oofbaroomf/haptic-headband/cad/01_Front.png

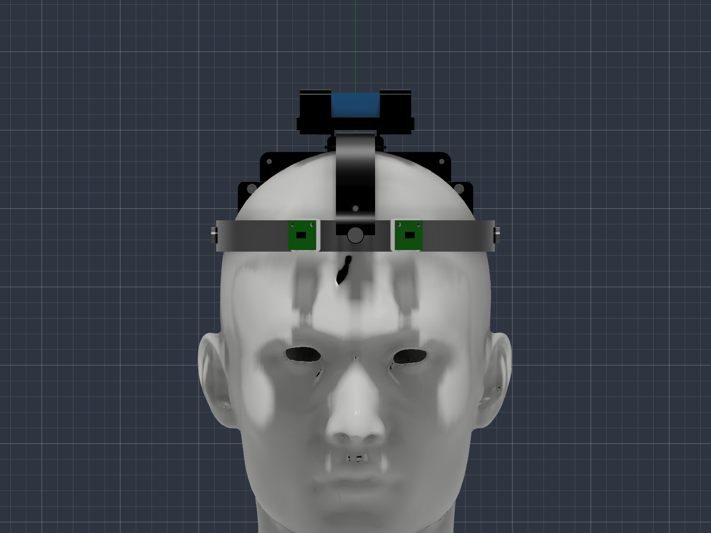
cad/01_Front.png
