oofbaroomf/haptic-headband/cad/02_Rear.png

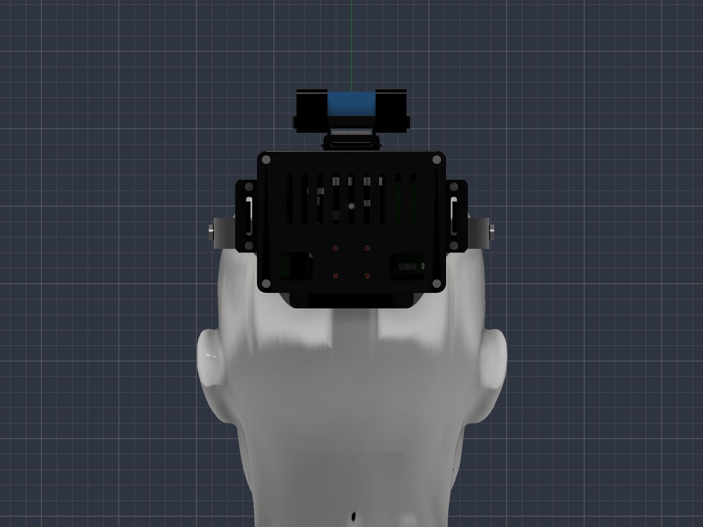
cad/02_Rear.png
