oofbaroomf/haptic-headband/cad/03_Side.png

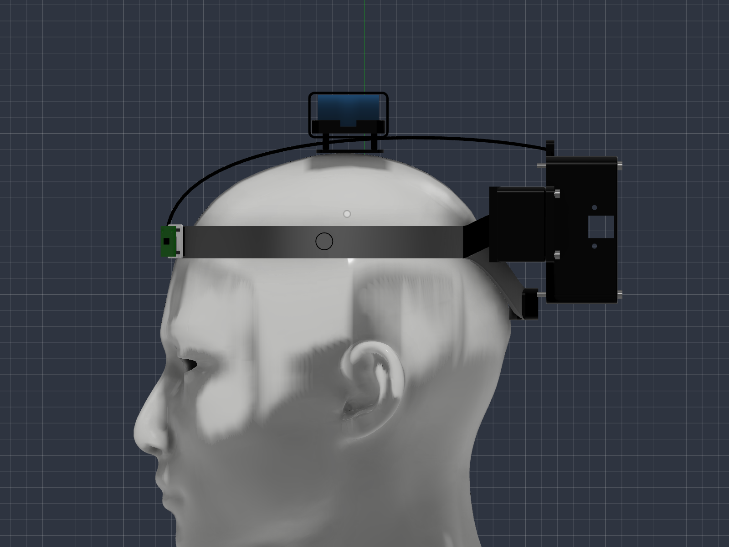
cad/03_Side.png
