oofbaroomf/haptic-headband/cad/04_Top.png

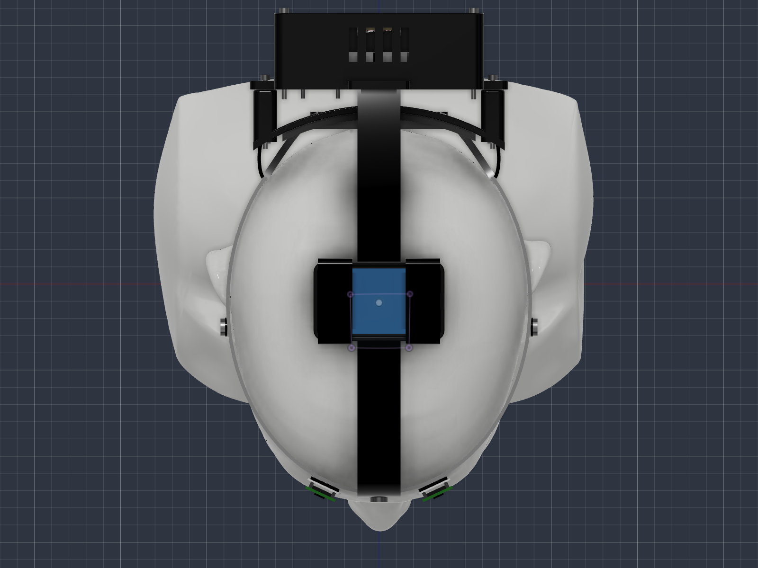
cad/04_Top.png
