oofbaroomf/haptic-headband/cad/06_Headband_Only.png

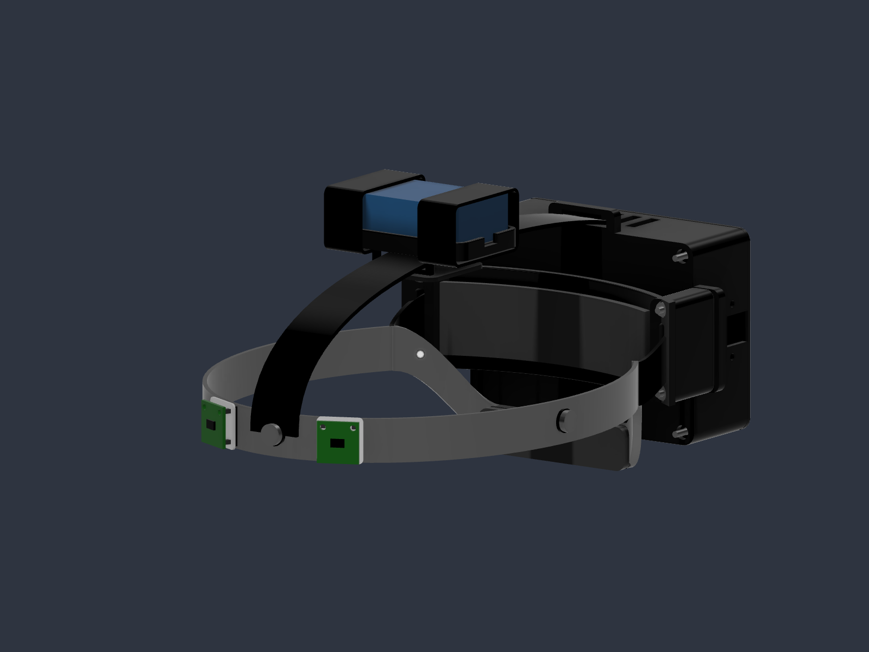
cad/06_Headband_Only.png
