oofbaroomf/haptic-headband/cad/07_Rear_Interior.png

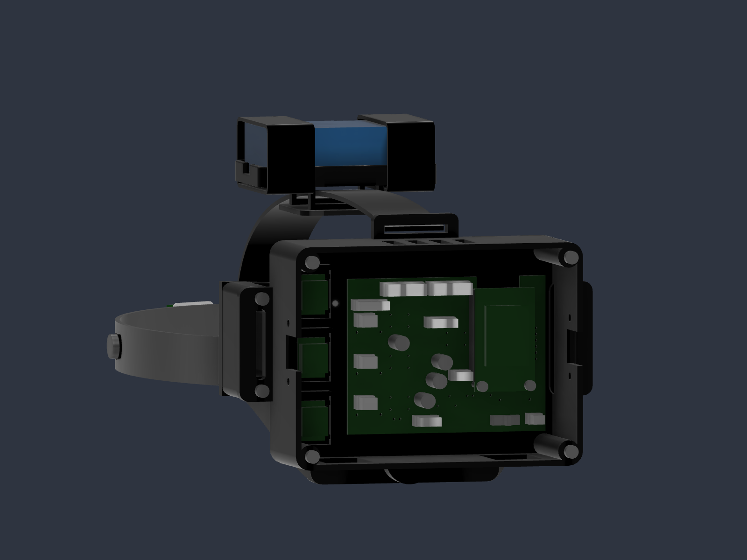
cad/07_Rear_Interior.png
