oofbaroomf/haptic-headband/cad/11_Curved_Saddle.png

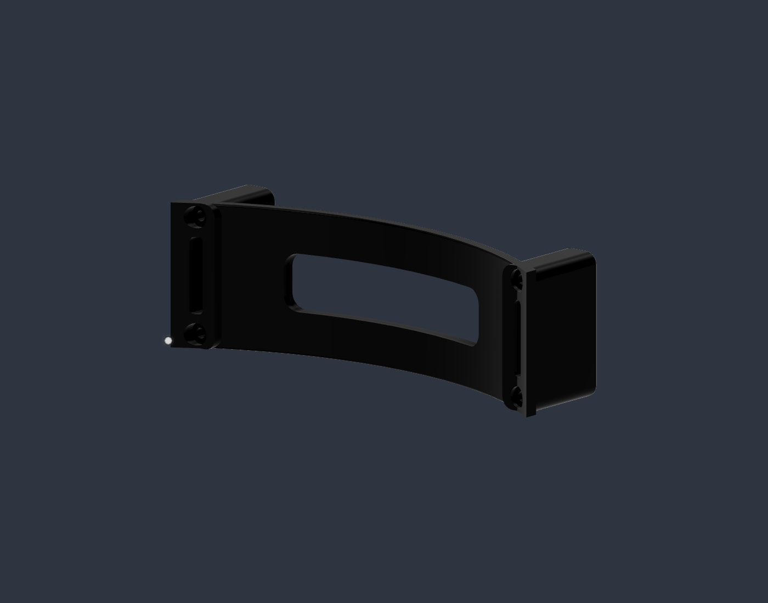
cad/11_Curved_Saddle.png
