oofbaroomf/haptic-headband/BOM.csv

Category | Reference | Quantity | Functional description | Manufacturer | Manufacturer part number | Supplier | Supplier part number | Component value | Package | Footprint | THT/SMD | Electrical rating | Verified datasheet link | Verification status | Assembly notes | Procurement status | Supplier link
Prebuilt module on carrier | U1 | 1 | Exact purchased controller | Adafruit | 4172 | To source |  |  | HUZZAH32 breakout | CAD-derived 36 pads | Socketed THT | VIN34 receives regulated4.70V; BAT30 NC | https://github.com/adafruit/Adafruit-ESP32-HUZZAH-Breakout-PCB | CAD verified; physical fit pending | Two 15-way socket rows plus insulated VIN34 service jumper; leave programming interface accessible; use signal-only programming cable, VIN power contact isolated | Purchased (user reported) | https://github.com/adafruit/Adafruit-ESP32-HUZZAH-Breakout-PCB
Controller PCB | Q1 Q2 Q3 Q5 | 4 | Three motor switches and power-gate control | Diodes Incorporated | DMN2056U-7 | JLCPCB assembly | C332302 |  | SOT23 | Sot23 G1 S2 D3 | SMD | 20V; RDSon <=85mohm at VGS1.5V at25C | https://www.diodes.com/datasheet/download/DMN2056U.pdf | Datasheet/land pattern verified | New selection; not purchased PN2222; qualify thermal layout | Included in R3A PCBA; not yet ordered | https://jlcpcb.com/partdetail/C332302
Controller PCB | Q4 Q6 | 2 | High-side power and reverse battery protection | Diodes Incorporated | DMP2035U-7 | JLCPCB assembly | C110499 |  | SOT23 | Sot23 G1 S2 D3 | SMD | -20V; RDSon <=45mohm at VGS-2.5V at25C | https://www.diodes.com/datasheet/download/DMP2035U.pdf | Datasheet/land pattern verified | Q6 D to raw battery; Q4 S to protected battery | Included in R3A PCBA; not yet ordered | https://jlcpcb.com/partdetail/C110499
Controller PCB | D1 D2 D3 | 3 | Motor flyback rectifiers | STMicroelectronics | 1N5819 | JLCPCB assembly | C110032 |  | DO-41 | Axial P10.16 D2.7 L5.2 | THT | 40V 1A; transient energy still unqualified | https://www.st.com/resource/en/datasheet/1n5819.pdf | Published rating verified; bench clamp test pending | Cathode band goes to motor positive/pad2 | Included in R3A PCBA; not yet ordered | https://jlcpcb.com/partdetail/C110032
Controller PCB | R1 R2 R3 | 3 | Gate resistors | Yageo | MFR-25FTF52-330R | JLCPCB assembly | C1372966 | 330 ohm | 0.25W axial | Axial DIN0207 P7.62 D2.5 L6.3 | THT | 0.25W 1%; body6.3x2.4mm | https://www.yageogroup.com/component-documentation/download/specsheet/MFR-25FBF52-1M | Family/ordering code verified; purchased stock fit pending | Selected new orderable part; compare existing purchased resistors before reuse | Included in R3A PCBA; not yet ordered | https://jlcpcb.com/partdetail/C1372966
Controller PCB | R4 R5 R6 | 3 | Strong reset-state motor OFF bias | Yageo | MFR-25FBF52-1K | JLCPCB assembly | C1364484 | 1k ohm | 0.25W axial | Axial DIN0207 P7.62 D2.5 L6.3 | THT | 0.25W 1%; body6.3x2.4mm | https://www.yageogroup.com/component-documentation/download/specsheet/MFR-25FBF52-1M | Family/ordering code verified; purchased stock fit pending | Selected new orderable part; compare existing purchased resistors before reuse | Included in R3A PCBA; not yet ordered | https://jlcpcb.com/partdetail/C1364484
Controller PCB | R12 | 1 | Power-gate enable pulldown | Yageo | MFR-25FTE52-100K | JLCPCB assembly | C172965 | 100k ohm | 0.25W axial | Axial DIN0207 P7.62 D2.5 L6.3 | THT | 0.25W 1%; body6.3x2.4mm | https://www.yageogroup.com/component-documentation/download/specsheet/MFR-25FBF52-1M | Family/ordering code verified; purchased stock fit pending | Selected new orderable part; compare existing purchased resistors before reuse | Included in R3A PCBA; not yet ordered | https://jlcpcb.com/partdetail/C172965
Controller PCB | R10 R11 R13 R14 | 4 | Power gate pullup and switch series resistor | Yageo | MFR-25FTE52-10K | JLCPCB assembly | C172967 | 10k ohm | 0.25W axial | Axial DIN0207 P7.62 D2.5 L6.3 | THT | 0.25W 1%; body6.3x2.4mm | https://www.yageogroup.com/component-documentation/download/specsheet/MFR-25FBF52-1M | Family/ordering code verified; purchased stock fit pending | Selected new orderable part; compare existing purchased resistors before reuse | Included in R3A PCBA; not yet ordered | https://jlcpcb.com/partdetail/C172967
Controller PCB | C1 | 1 | Bulk/sensor decoupling | Panasonic | EEUFR1A221 | JLCPCB assembly | C407869 | 220uF | Radial electrolytic | Radial D6.3 P2.5 | THT | 10V;455mArms100kHz;.13ohm | https://industrial.panasonic.com/content/data/CP/PDF/S_Alm_A_cap_catalog_am.pdf | Manufacturer dimensions verified; operating ripple test pending | Positive lead pad1; C1/C2 height11.2mm; C3 height11.0mm | Included in R3A PCBA; not yet ordered | https://jlcpcb.com/partdetail/C407869
Controller PCB | C2 | 1 | Bulk/sensor decoupling | Panasonic | EEUFM1E101 | JLCPCB assembly | C713389 | 100uF | Radial electrolytic | Radial D6.3 P2.5 | THT | 25V;455mArms100kHz;0.13ohm;2000h105C | https://industrial.panasonic.com/content/data/CP/PDF/S_Alm_A_cap_catalog_am.pdf | Manufacturer dimensions verified; operating ripple test pending | Positive lead pad1; C1/C2 height11.2mm; C3 height11.0mm | Included in R3A PCBA; not yet ordered | https://jlcpcb.com/partdetail/C713389
Controller PCB | C3 | 1 | Bulk/sensor decoupling | Panasonic | EEUFM1E101 | JLCPCB assembly | C713389 | 100uF | Radial electrolytic | Radial D6.3 P2.5 | THT | 25V;455mArms100kHz;0.13ohm;2000h105C | https://industrial.panasonic.com/content/data/CP/PDF/S_Alm_A_cap_catalog_am.pdf | Manufacturer dimensions verified; operating ripple test pending | Positive pad1. Replaces 47uF; sensor reservoir only. New R3A footprint. | Included in R3A PCBA; not yet ordered | https://jlcpcb.com/partdetail/C713389
Controller PCB | C10 | 1 | Controller-input radio-burst reservoir | Panasonic | EEUFR1A221 | JLCPCB assembly | C407869 | 220uF | Radial electrolytic | Radial D6.3 P2.5 | THT | 10V; 455mArms at100kHz; ESR0.13ohm | https://industrial.panasonic.com/content/data/CP/PDF/S_Alm_A_cap_catalog_am.pdf | Manufacturer footprint checked; transient qualification required | Positive pad1 to VCTRL_4V7; leave room for 11.2mm height | Included in R3A PCBA; not yet ordered | https://jlcpcb.com/partdetail/C407869
Controller PCB | SW1 | 1 | Purchased physical slide switch | Adafruit / Dongguan Haoyu | 805 / SS-12E17G2 | To source |  |  | SPDT THT | Switch805 P2.50 drill1.0 | THT | 0.5A DC50V; carries enable current only | https://cdn-shop.adafruit.com/product-files/805/SS-12E17G2-revised.pdf | Drawing inspected; purchased fit pending | Common2; unused1 NC; ON3; continuity-test actuator direction | Purchased (user reported) | https://cdn-shop.adafruit.com/product-files/805/SS-12E17G2-revised.pdf
Controller PCB | J1 J2 J3 | 3 | Motor interfaces | JST | B2B-XH-A(LF)(SN) | JLCPCB assembly | C158012 | 2 positions | XH keyed vertical header | XH 2x1 P2.5 | THT | 3A with specified contacts | https://www.jst.com/wp-content/uploads/2025/06/eXH.pdf | Manufacturer geometry checked; actual mating harness pending | Component-side pin1 at left; PH regulator unused positions NC; no unkeyed substitutes | Included in R3A PCBA; not yet ordered | https://jlcpcb.com/partdetail/C158012
Controller PCB | J4 J5 | 2 | ToF interfaces | JST | B6B-XH-A(LF)(SN) | JLCPCB assembly | C144397 | 6 positions | XH keyed vertical header | XH 6x1 P2.5 | THT | 3A with specified contacts | https://www.jst.com/wp-content/uploads/2025/06/eXH.pdf | Manufacturer geometry checked; actual mating harness pending | Component-side pin1 at left; PH regulator unused positions NC; no unkeyed substitutes | Included in R3A PCBA; not yet ordered | https://jlcpcb.com/partdetail/C144397
Controller PCB | J6 | 1 | IMU interface | JST | B6B-PH-K-S(LF)(SN) | JLCPCB assembly | C131342 | 6 positions | PH keyed vertical header | PH 6x1 P2 | THT | 2A with specified AWG24 contacts | https://www.jst.com/wp-content/uploads/2021/08/ePH-new.pdf | Manufacturer geometry checked; actual mating harness pending | Component-side pin1 at left; PH regulator unused positions NC; no unkeyed substitutes | Included in R3A PCBA; not yet ordered | https://jlcpcb.com/partdetail/C131342
Controller PCB | J7 | 1 | Fused battery input | JST | B2B-PH-K-S(LF)(SN) | JLCPCB assembly | C131337 | 2 positions | PH keyed vertical header | PH 2x1 P2 | THT | 2A with specified AWG24 contacts | https://www.jst.com/wp-content/uploads/2021/08/ePH-new.pdf | Manufacturer geometry checked; actual mating harness pending | Component-side pin1 at left; PH regulator unused positions NC; no unkeyed substitutes | Included in R3A PCBA; not yet ordered | https://jlcpcb.com/partdetail/C131337
Controller PCB | J8 | 1 | Sensor regulator | JST | B3B-PH-K-S(LF)(SN) | JLCPCB assembly | C131339 | 3 positions | PH keyed vertical header | PH 3x1 P2 | THT | 2A with specified AWG24 contacts | https://www.jst.com/wp-content/uploads/2021/08/ePH-new.pdf | Manufacturer geometry checked; actual mating harness pending | Component-side pin1 at left; PH regulator unused positions NC; no unkeyed substitutes | Included in R3A PCBA; not yet ordered | https://jlcpcb.com/partdetail/C131339
Controller PCB | J9 | 1 | Motor regulator | JST | B4B-PH-K-S(LF)(SN) | JLCPCB assembly | C131334 | 4 positions | PH keyed vertical header | PH 4x1 P2 | THT | 2A with specified AWG24 contacts | https://www.jst.com/wp-content/uploads/2021/08/ePH-new.pdf | Manufacturer geometry checked; actual mating harness pending | Component-side pin1 at left; PH regulator unused positions NC; no unkeyed substitutes | Included in R3A PCBA; not yet ordered | https://jlcpcb.com/partdetail/C131334
Controller PCB | J10 | 1 | Controller regulator | JST | B5B-PH-K-S(LF)(SN) | JLCPCB assembly | C157993 | 5 positions | PH keyed vertical header | PH 5x1 P2 | THT | 2A with specified AWG24 contacts | https://www.jst.com/wp-content/uploads/2021/08/ePH-new.pdf | Manufacturer geometry checked; actual mating harness pending | Component-side pin1 at left; PH regulator unused positions NC; no unkeyed substitutes | Included in R3A PCBA; not yet ordered | https://jlcpcb.com/partdetail/C157993
Controller PCB | JP1 | 1 | Arming/test header | Samtec | TSW-102-07-G-S | JLCPCB assembly | C7402729 | 2 positions | 2.54mm header | Header 2x1 | THT | System 2A target | https://www.samtec.com/products/tsw-102-07-g-s | Manufacturer geometry verified | JP1 normally open; TP1 not a harness socket | Included in R3A PCBA; not yet ordered | https://jlcpcb.com/partdetail/C7402729
Controller PCB | TP1 | 0 | Arming/test header | Samtec | TSW-106-07-G-S | To source |  | 6 positions | 2.54mm header | Header 6x1 | THT | System 2A target | https://www.samtec.com/products/tsw-106-07-g-s | Manufacturer geometry verified | Leave header unfitted; probe labelled holes. No purchase required. | DNP; use probe holes | https://www.samtec.com/products/tsw-106-07-g-s
Controller PCB | U2 | 1 | Dual-supply I2C powered-off isolation | Texas Instruments | TCA9517DR | JLCPCB assembly | C182421 |  | SOIC8 | TI D SOIC8 1.27mm | SMD | Aside sensor; Bside ESP; 400kHz maximum | https://www.ti.com/lit/ds/symlink/tca9517.pdf | Manufacturer pinout and land pattern checked | Not galvanic isolation; common ground required | Included in R3A PCBA; not yet ordered | https://jlcpcb.com/partdetail/C182421
Controller PCB | U6 | 1 | Battery ADC powered-off isolation | Texas Instruments | SN74CBTLV1G125DBVR | JLCPCB assembly | C2653264 |  | SOT23-5 | TI DBV | SMD | 2.3-3.6V supply; Ioff10uA maximum | https://www.ti.com/lit/ds/symlink/sn74cbtlv1g125.pdf | Datasheet checked | GPIO33 open-drain enable; divider ratio approximately3:1; calibrate | Included in R3A PCBA; not yet ordered | https://jlcpcb.com/partdetail/C2653264
Controller PCB | U3 | 1 | Open-drain LP isolation | Texas Instruments | SN74LVC2G07DBVR | JLCPCB assembly | C37708 |  | SOT23-6 | TI DBV 0.95mm | SMD | Ioff partial-power-down; output sink only | https://www.ti.com/lit/ds/symlink/sn74lvc2g07.pdf | Manufacturer pinout and land pattern checked | Controller-side pullups; never pull LP output to 3.3V | Included in R3A PCBA; not yet ordered | https://jlcpcb.com/partdetail/C37708
Controller PCB | U4 U5 | 2 | UART powered-off isolation | Texas Instruments | SN74LVC1G125DBVR | JLCPCB assembly | C23654 |  | SOT23-5 | TI DBV 0.95mm | SMD | Ioff partial-power-down; 5.5V tolerant input | https://www.ti.com/lit/ds/symlink/sn74lvc1g125.pdf | Manufacturer pinout and land pattern checked | Each buffer powered by receiving domain; OE grounded | Included in R3A PCBA; not yet ordered | https://jlcpcb.com/partdetail/C23654
Controller PCB | R15 R16 | 2 | Interface bias | Yageo | RC1206FR-074K7L | JLCPCB assembly | C137262 | 4.7k | 1206 | Chip1206 | SMD | 1%; 0.25W | https://yageogroup.com/component-documentation/download/specsheet/RC1206FR-0710KL | Manufacturer package dimensions checked | Not confirmed purchased | Included in R3A PCBA; not yet ordered | https://jlcpcb.com/partdetail/C137262
Controller PCB | R17 R18 R21 R22 | 4 | Interface bias | Yageo | RC1206FR-0710KL | JLCPCB assembly | C132649 | 10k | 1206 | Chip1206 | SMD | 1%; 0.25W | https://yageogroup.com/component-documentation/download/specsheet/RC1206FR-0710KL | Manufacturer package dimensions checked | Not confirmed purchased | Included in R3A PCBA; not yet ordered | https://jlcpcb.com/partdetail/C132649
Controller PCB | R19 R20 | 2 | Interface bias | Yageo | RC1206FR-07100KL | JLCPCB assembly | C137393 | 100k | 1206 | Chip1206 | SMD | 1%; 0.25W | https://yageogroup.com/component-documentation/download/specsheet/RC1206FR-0710KL | Manufacturer package dimensions checked | Not confirmed purchased | Included in R3A PCBA; not yet ordered | https://jlcpcb.com/partdetail/C137393
Controller PCB | C4 C5 C6 C7 C8 C9 | 6 | Local interface decoupling | KEMET | C1206C104K5RACTU | JLCPCB assembly | C41430990 | 100nF | 1206 | Chip1206 | SMD | 50V X7R 10% | https://search.kemet.com/component-documentation/download/specsheet/C1206C104K5RACTU | Manufacturer package dimensions checked | Not confirmed purchased | Included in R3A PCBA; not yet ordered | https://jlcpcb.com/partdetail/C41430990
Controller PCB | F1 | 1 | PCB-mounted battery-positive fuse | Littelfuse | 0251002.NRT1L | JLCPCB assembly | C151088 | 2A | Axial PICO 251 | Axial P12.7 D2.8 L7.11 drill1.0 | THT | 125V; 300A DC interrupt; very fast acting | https://www.littelfuse.com/assetdocs/littelfuse-fuse-251-253-datasheet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 | Datasheet reviewed; coordination pending | J7.1 to F1.1; F1.2 feeds BAT_RAW; same 251-series2A. No inline fuse adapter required. Use protected pack with short retained leads. | Included in R3A PCBA; not yet ordered | https://jlcpcb.com/partdetail/C151088
Harness mating part | MATE_PH2 | 0 | Keyed cable housing | JST | PHR-2 | To source |  | 2 circuits | PH | External | Wired | Use AWG24; 2A | https://www.jst.com/wp-content/uploads/2021/08/ePH-new.pdf | Manufacturer family verified | Housing alone excludes contacts; use matching crimp tool | Removed in R3A; use protected battery integral connector after polarity check | https://www.jst.com/wp-content/uploads/2021/08/ePH-new.pdf
Harness mating part | MATE_PH3 | 1 | Keyed cable housing | JST | PHR-3 | To source |  | 3 circuits | PH | External | Wired | Use AWG24; 2A | https://www.jst.com/wp-content/uploads/2021/08/ePH-new.pdf | Manufacturer family verified | Housing alone excludes contacts; use matching crimp tool | Planned / not confirmed purchased | https://www.jst.com/wp-content/uploads/2021/08/ePH-new.pdf
Harness mating part | MATE_PH4 | 1 | Keyed cable housing | JST | PHR-4 | To source |  | 4 circuits | PH | External | Wired | Use AWG24; 2A | https://www.jst.com/wp-content/uploads/2021/08/ePH-new.pdf | Manufacturer family verified | Housing alone excludes contacts; use matching crimp tool | Planned / not confirmed purchased | https://www.jst.com/wp-content/uploads/2021/08/ePH-new.pdf
Harness mating part | MATE_PH5 | 1 | Keyed cable housing | JST | PHR-5 | To source |  | 5 circuits | PH | External | Wired | Use AWG24; 2A | https://www.jst.com/wp-content/uploads/2021/08/ePH-new.pdf | Manufacturer family verified | Housing alone excludes contacts; use matching crimp tool | Planned / not confirmed purchased | https://www.jst.com/wp-content/uploads/2021/08/ePH-new.pdf
Harness mating part | MATE_PH6 | 1 | Keyed cable housing | JST | PHR-6 | To source |  | 6 circuits | PH | External | Wired | Use AWG24; 2A | https://www.jst.com/wp-content/uploads/2021/08/ePH-new.pdf | Manufacturer family verified | Housing alone excludes contacts; use matching crimp tool | Planned / not confirmed purchased | https://www.jst.com/wp-content/uploads/2021/08/ePH-new.pdf
Harness mating part | MATE_XH2 | 3 | Keyed cable housing | JST | XHP-2 | To source |  | 2 circuits | XH | External | Wired | Use AWG24; 3A | https://www.jst.com/wp-content/uploads/2025/06/eXH.pdf | Manufacturer family verified | Housing alone excludes contacts; use matching crimp tool | Planned / not confirmed purchased | https://www.jst.com/wp-content/uploads/2025/06/eXH.pdf
Harness mating part | MATE_XH6 | 2 | Keyed cable housing | JST | XHP-6 | To source |  | 6 circuits | XH | External | Wired | Use AWG24; 3A | https://www.jst.com/wp-content/uploads/2025/06/eXH.pdf | Manufacturer family verified | Housing alone excludes contacts; use matching crimp tool | Planned / not confirmed purchased | https://www.jst.com/wp-content/uploads/2025/06/eXH.pdf
Harness mating part | CONTACT_PH | 10 | Double-ended pre-crimped leads; cut in half | JST | ASPHSPH24K305 | DigiKey | 455-3083-ND | 24 AWG | 304.8 mm double-ended lead | External cable | Wired | PH contacts, 24 AWG | https://www.digikey.co.uk/en/products/detail/jst-sales-america-inc/ASPHSPH24K305/6009459 | Exact pre-crimp family verified | 20 half-leads per pack of10; no crimp tool or separate terminals | Planned / not confirmed purchased | https://www.digikey.co.uk/en/products/detail/jst-sales-america-inc/ASPHSPH24K305/6009459
Harness mating part | CONTACT_XH | 10 | Double-ended pre-crimped leads; cut in half | JST | ASXHSXH22K305 | DigiKey | 455-3241-ND | 22 AWG | 304.8 mm double-ended lead | External cable | Wired | XH contacts, 22 AWG | https://www.digikey.co.uk/en/products/detail/jst-sales-america-inc/ASXHSXH22K305/6684932 | Exact pre-crimp family verified | 20 half-leads per pack of10; no crimp tool or separate terminals | Planned / not confirmed purchased | https://www.digikey.co.uk/en/products/detail/jst-sales-america-inc/ASXHSXH22K305/6684932
Mechanical assembly | SK1 SK2 | 2 | HUZZAH socket strips | Samtec | SSW-115-01-T-S | JLCPCB assembly | C6686518 | 15 positions | 2.54mm single row female | Header row length35.56 | THT | Mechanical stack/clearance to verify | https://www.samtec.com/products/ssw-115-01-t-s | Family confirmed; selected tin variant dry fit pending | Sockets occupy U1 main rows; no separate PCB reference required | Included in R3A PCBA; not yet ordered | https://jlcpcb.com/partdetail/C6686518
Remote wired module | TOF_LEFT TOF_RIGHT | 2 | Purchased ToF breakout | Pimoroni | PIM622 | To source |  |  | 19x19mm breakout | Not mounted on carrier | Remote | Published input3-6V; host bus3.3V | https://cdn.shopify.com/s/files/1/0174/1800/files/VL53L5CX-schematic.pdf?v=1654004213 | Schematic verified; module revision/harness test pending | Rear LP wire required; open-drain controls | Purchased (user reported) | https://cdn.shopify.com/s/files/1/0174/1800/files/VL53L5CX-schematic.pdf?v=1654004213
Remote wired module | IMU1 | 1 | Purchased inertial breakout | Adafruit | 4754 (selected; confirm purchased SKU) | To source |  |  | BNO085 module | Not mounted on carrier | Remote | VIN3-5V;3.3V UART | https://learn.adafruit.com/adafruit-9-dof-orientation-imu-fusion-breakout-bno085/pinouts | Pinout verified; exact purchased SKU/revision pending | P1high/P0low normal UART; never power3VO | Purchased (user reported) | https://learn.adafruit.com/adafruit-9-dof-orientation-imu-fusion-breakout-bno085/pinouts
New external power module | REG_SENS | 1 | Independent sensor buck-boost | Pololu | S7V8F3 / 2122 | To source |  | 3.3V | Module11.4x16.5mm | Wired to J8 | Remote module | VIN2.7-11.8V; current depends on conditions | https://www.pololu.com/product/2122 | Published capability verified; .30A allocation needs test | New purchase required; label-based wiring; SHDN open; insulate/mount | Planned / not confirmed purchased | https://www.pololu.com/product/2122
New external power module | REG_MOTOR | 1 | Adjustable motor buck-boost | Pololu | S7V8A / 2118 | To source |  | 3.0V | Module11.4x16.5mm | Wired to J9 | Remote module | VIN2.7-11.8V; VOUT2.5-8V | https://www.pololu.com/product/2118 | Reference motor voltage/current verified; batch and transient test pending | Set3.00V; accept2.90-3.10V under load; secure trimmer; no motors above3.8V | Planned / not confirmed purchased | https://www.pololu.com/product/2118
Remote purchased component | M_LEFT M_RIGHT M_FRONT | 3 | Pi Hut vibration discs SKU102867 | Batch manufacturer unconfirmed | Reference only: 10B27.3018 / Adafruit1201 | The Pi Hut | 102867 | 3.0V target | 10x2.7mm coin reference | Not mounted on carrier | Wired | Reference:2.5-3.8V;75mA running;120mA starting at25C | https://cdn-shop.adafruit.com/product-files/1201/P1012_datasheet.pdf | Reference verified; batch equivalence unconfirmed | Three purchased motors; measure startup; JP1 normally open | Purchased (user reported) | https://thepihut.com/products/vibrating-mini-motor-disc
Remote planned component | BAT1 | 1 | Pimoroni BAT0007 protected parallel-cell pack | PKCell | ICR18650 4400mAh 3.7V | Pimoroni | BAT0007 | 4400mAh typical;3960mAh minimum | 1S2P lithium-ion | External to PCB | Wired | 4.2V charge;3.0V cutoff;3A max continuous charge/discharge | https://cdn.shopify.com/s/files/1/0174/1800/files/PKcell_ICR18650_4400mAh_Final.pdf?11497089046215477949= | Manufacturer reference verified; not purchased | Protected pack directly to J7 only after verifying + on J7.1 and - on J7.2. F1 now onboard. Short intact retained cable; unplug to charge. | Planned / not confirmed purchased | https://shop.pimoroni.com/products/lithium-ion-battery-pack?variant=23417820423
New external power module | REG_CTRL | 1 | Adjustable controller supply for wireless demo | Pololu | S7V8A / 2118 | To source |  | 4.70V | Module11.4x16.5mm | Wired to J10 | Remote module | VIN2.7-11.8V;typical500mA-1A output; thermal qualification required | https://www.pololu.com/product/2118 | Set4.70V; qualify4.415-4.985V at HUZZ input under load | Distinct 4V7 label; secure trimmer; VOUT to J10.3 then U1 VIN34; BAT30 NC; programmer power absent | Planned / not confirmed purchased | https://www.pololu.com/product/2118
External charging accessory | CHARGER1 | 1 | Purchased USB-C charger | Adafruit | 4410 | To source |  |  | MicroLipo USB-C | Not on carrier | External | 100mA default;500mA selectable | https://www.adafruit.com/product/4410 | 4.2V chemistry/current compatible; physical polarity mandatory | Pack disconnected from carrier;100mA default or500mA bridge; no load sharing | Purchased (user reported) | https://www.adafruit.com/product/4410
Not fitted | JP1_SHUNT | 1 | Motor arming shunt | Harwin | M7566-05 | To source |  | 2.54mm shunt | 2-pin jumper | JP1 | Manual | 3A at25C;2.54mm pitch;0.64mm square mating post | https://www.harwin.com/products/M7566-05 | Published rating verified; DNP until motor qualification | Red open shunt;5.00x2.30x6.30mm; fit only after electrical acceptance | DNP - not installed | https://www.harwin.com/products/M7566-05
Custom external harness | HARNESS_BAT | 0 | Retained polarity-verified battery adapter | Custom assembly | HB-BAT-ADAPTER-01 (assembly drawing, not vendor MPN) | To source |  | AWG24 PH leads; fused near battery connector | JST-PH2.0 keyed fused adapter | External to PCB | Wired | >=2A continuous mating-contact requirement |  | Actual matching connector required; meter polarity and qualify retention | Removed: F1 is on R3A PCB. Retain protected pack factory lead; meter polarity before J7. | Removed in R3A
Custom external harness | HARNESS_CTRL | 1 | Insulated removable VIN service jumper | Custom assembly | HB-VIN-JUMPER-01 (assembly drawing, not vendor MPN) | To source |  | 4.70V controller link | Insulated wire/link | Carrier U1.34 to breakout VIN | Wired | >=0.5A; insulated >=10V |  | Dry fit and continuity required | Main15-way sockets do not contact VIN34; isolate programmer power lead | Planned / not confirmed purchased
