oofbaroomf/haptic-headband/cad/Headband_Assembly.step

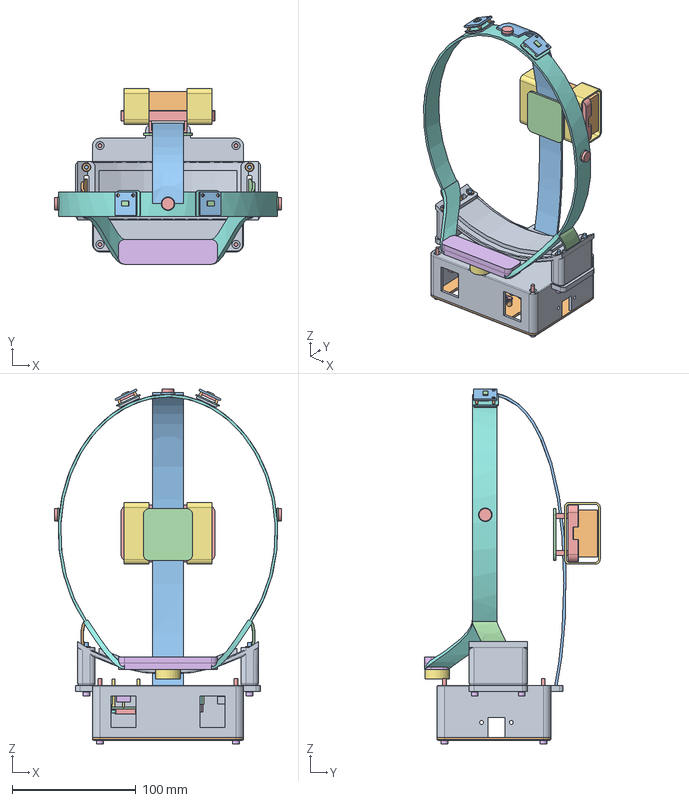
[picture p12: CAD file, 2026-11-01]
cad/Headband_Assembly.step
184.0 x 142.0 x 287.1 mm
