oofbaroomf/haptic-headband/cad/PRINT_3_Curved_Saddle.step

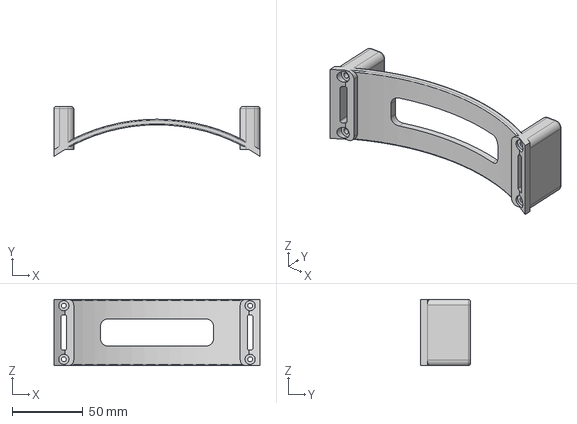
[picture p13: CAD file, 2026-11-01]
cad/PRINT_3_Curved_Saddle.step
146.0 x 35.4 x 47.0 mm
