oofbaroomf/haptic-headband/cad/PRINT_2_Rear_Lid.step

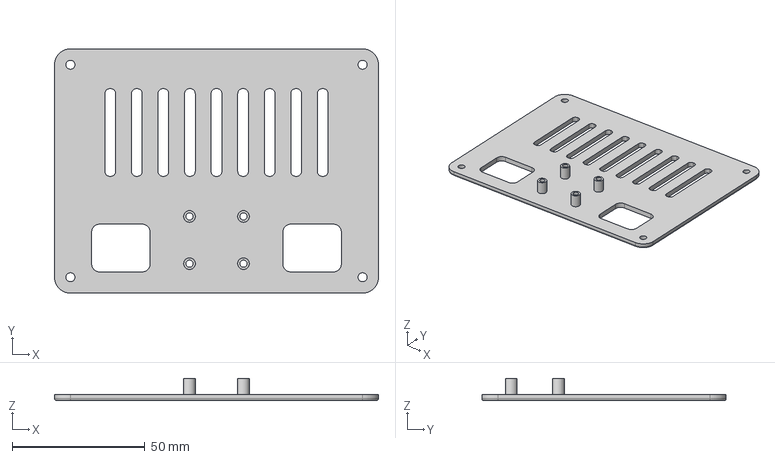
[picture p14: CAD file, 2026-11-01]
cad/PRINT_2_Rear_Lid.step
122.0 x 92.0 x 8.40 mm
