oofbaroomf/haptic-headband/cad/Headband_With_Original_Head.step

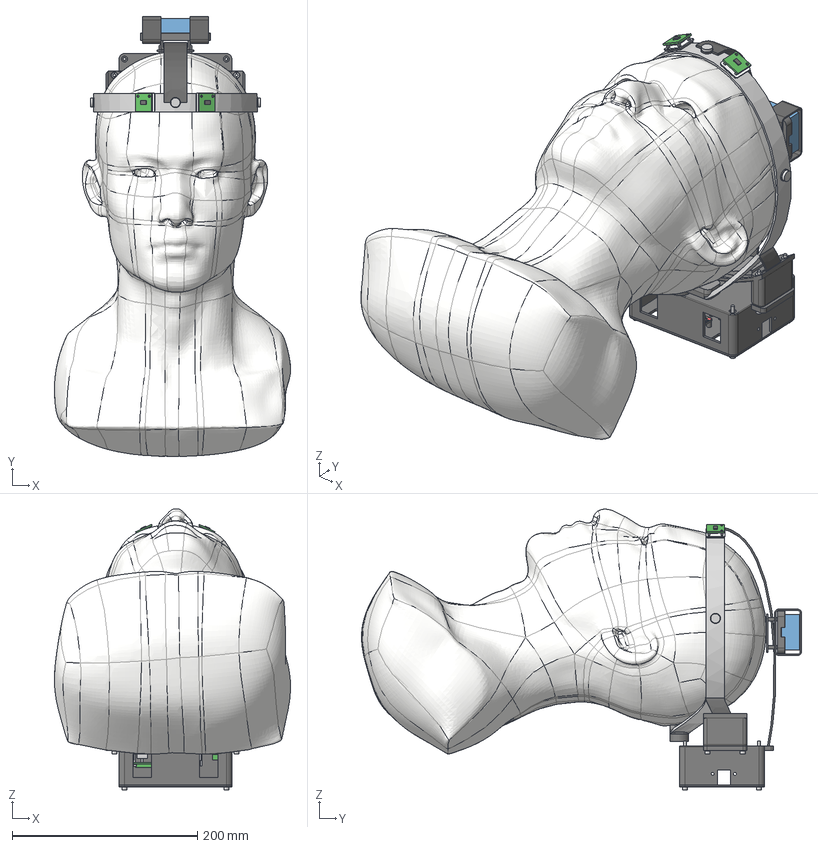
[picture p15: CAD file, 2026-11-01]
cad/Headband_With_Original_Head.step
255.3 x 475.6 x 303.6 mm
