oofbaroomf/haptic-headband/cad/PRINT_1_Rear_Base.step

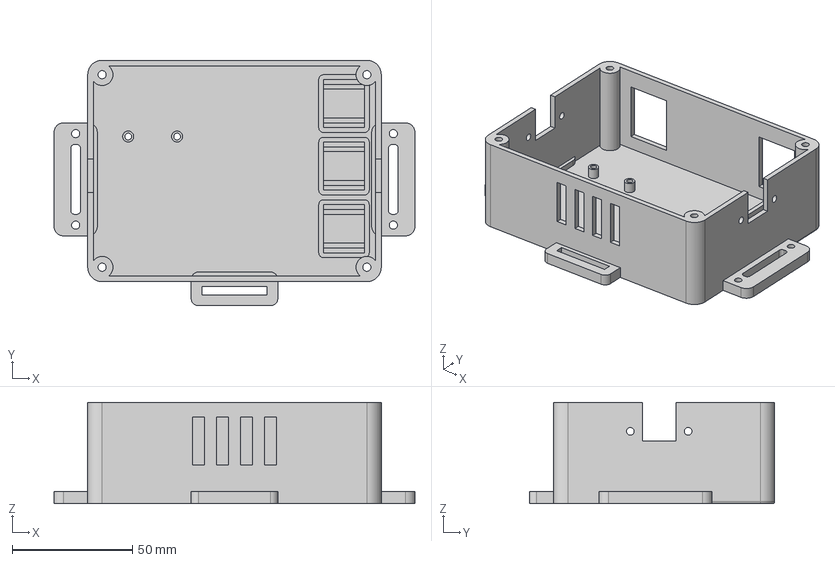
[picture p16: CAD file, 2026-11-01]
cad/PRINT_1_Rear_Base.step
150.0 x 102.0 x 42.0 mm
