oofbaroomf/haptic-headband/cad/PRINT_4_Battery_Tray.step

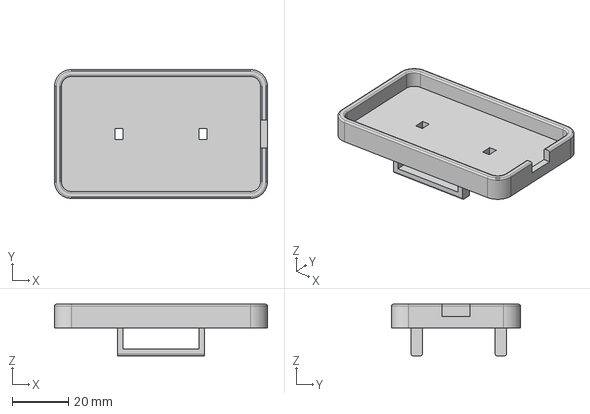
[picture p17: CAD file, 2026-11-01]
cad/PRINT_4_Battery_Tray.step
76.0 x 46.0 x 18.4 mm
