oofbaroomf/haptic-headband/(list of files, cad)

Other CAD files:
cad/Headband_Ergonomic_Revision.f3d
cad/PRINT_1_Rear_Base.stl
cad/PRINT_2_Rear_Lid.stl
cad/PRINT_3_Curved_Saddle.stl
cad/PRINT_4_Battery_Tray.stl
