oofbaroomf/haptic-headband/cad/10_Battery_Strap_Guides.png

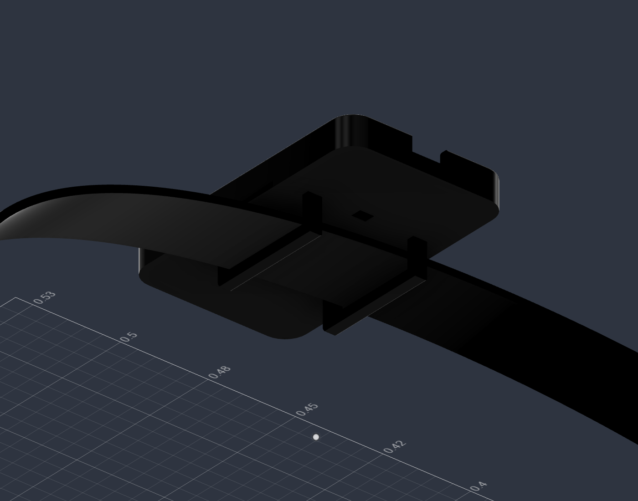
cad/10_Battery_Strap_Guides.png
