oofbaroomf/haptic-headband/pcb/headband-review.kicad_pcb

## KiCad design pcb/headband-review.kicad_pcb (2026-11-01)

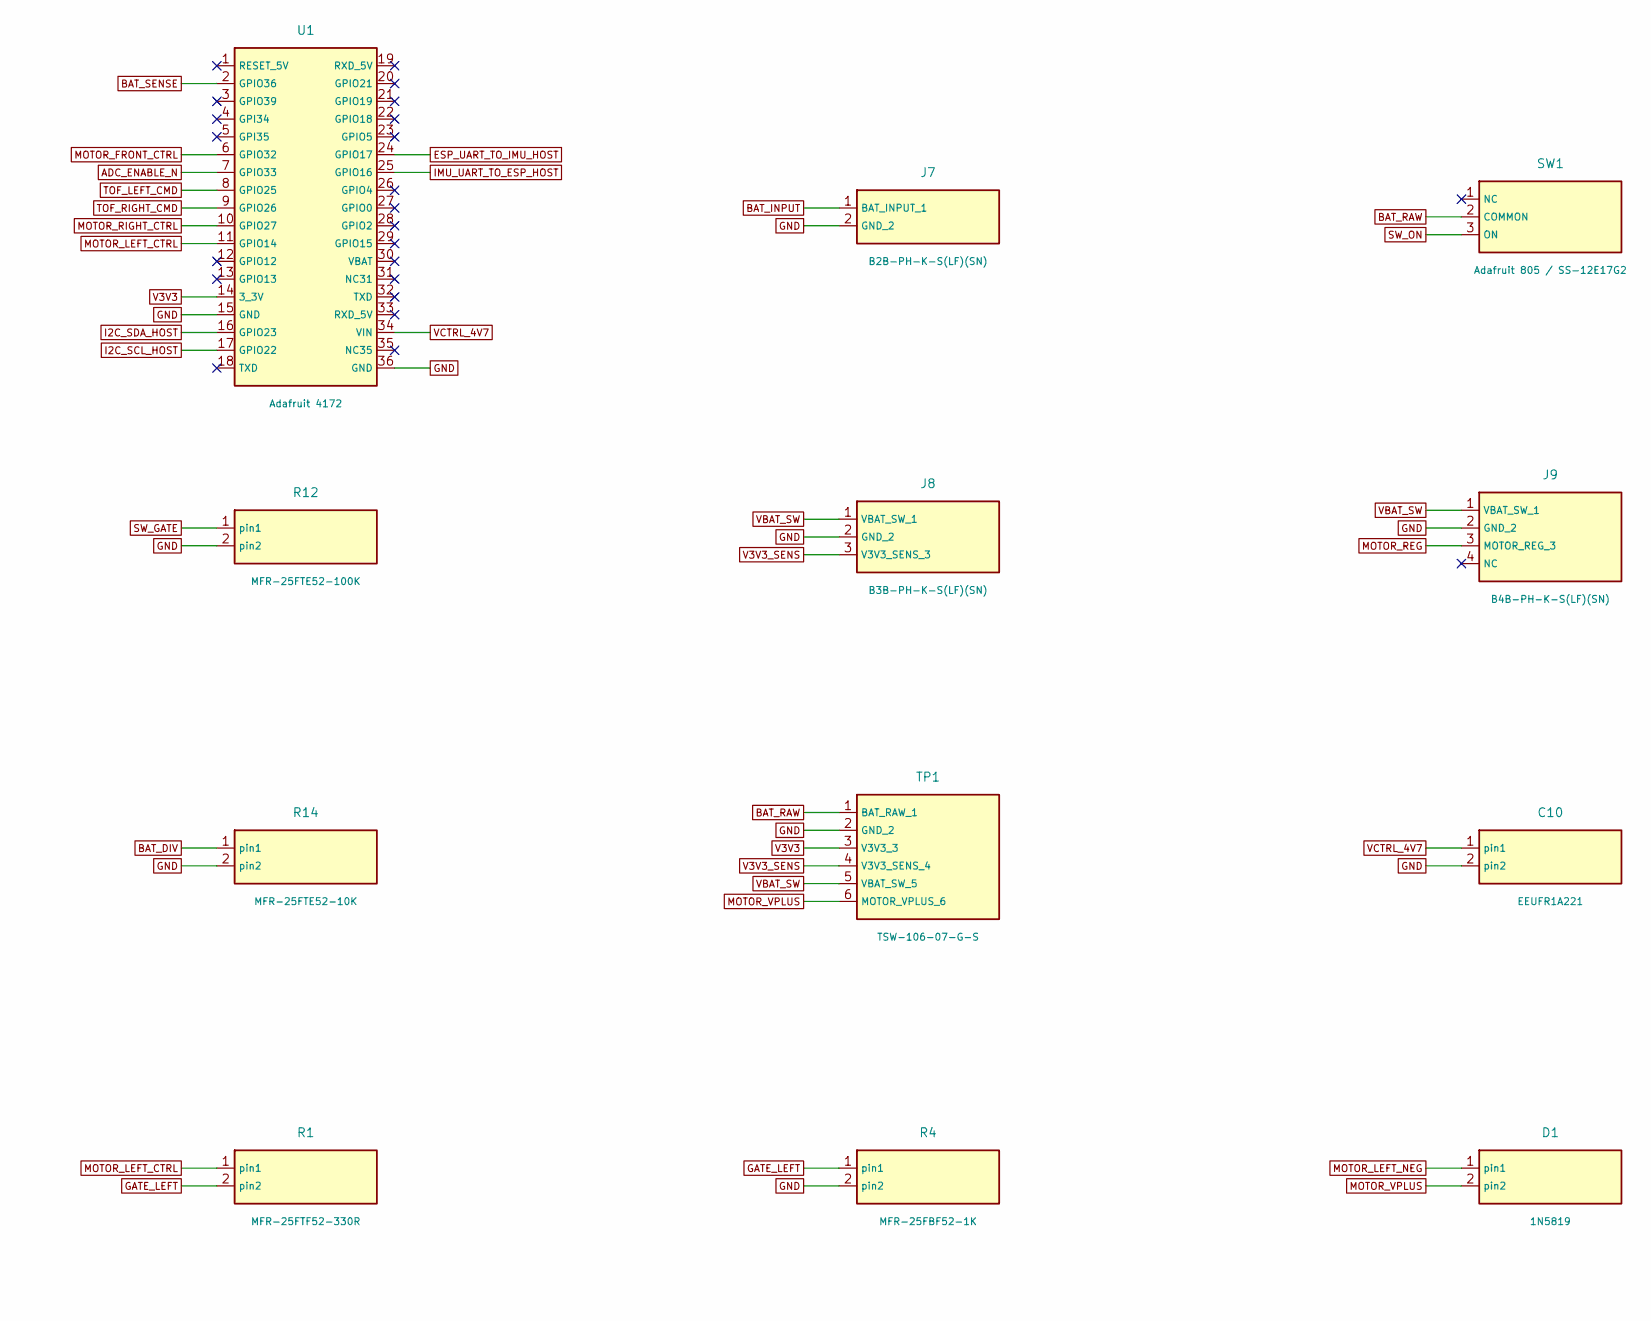
[picture p19: schematic headband-review.kicad_sch, Haptic navigation headband - carrier interface schematic, part in row 1, column 1]

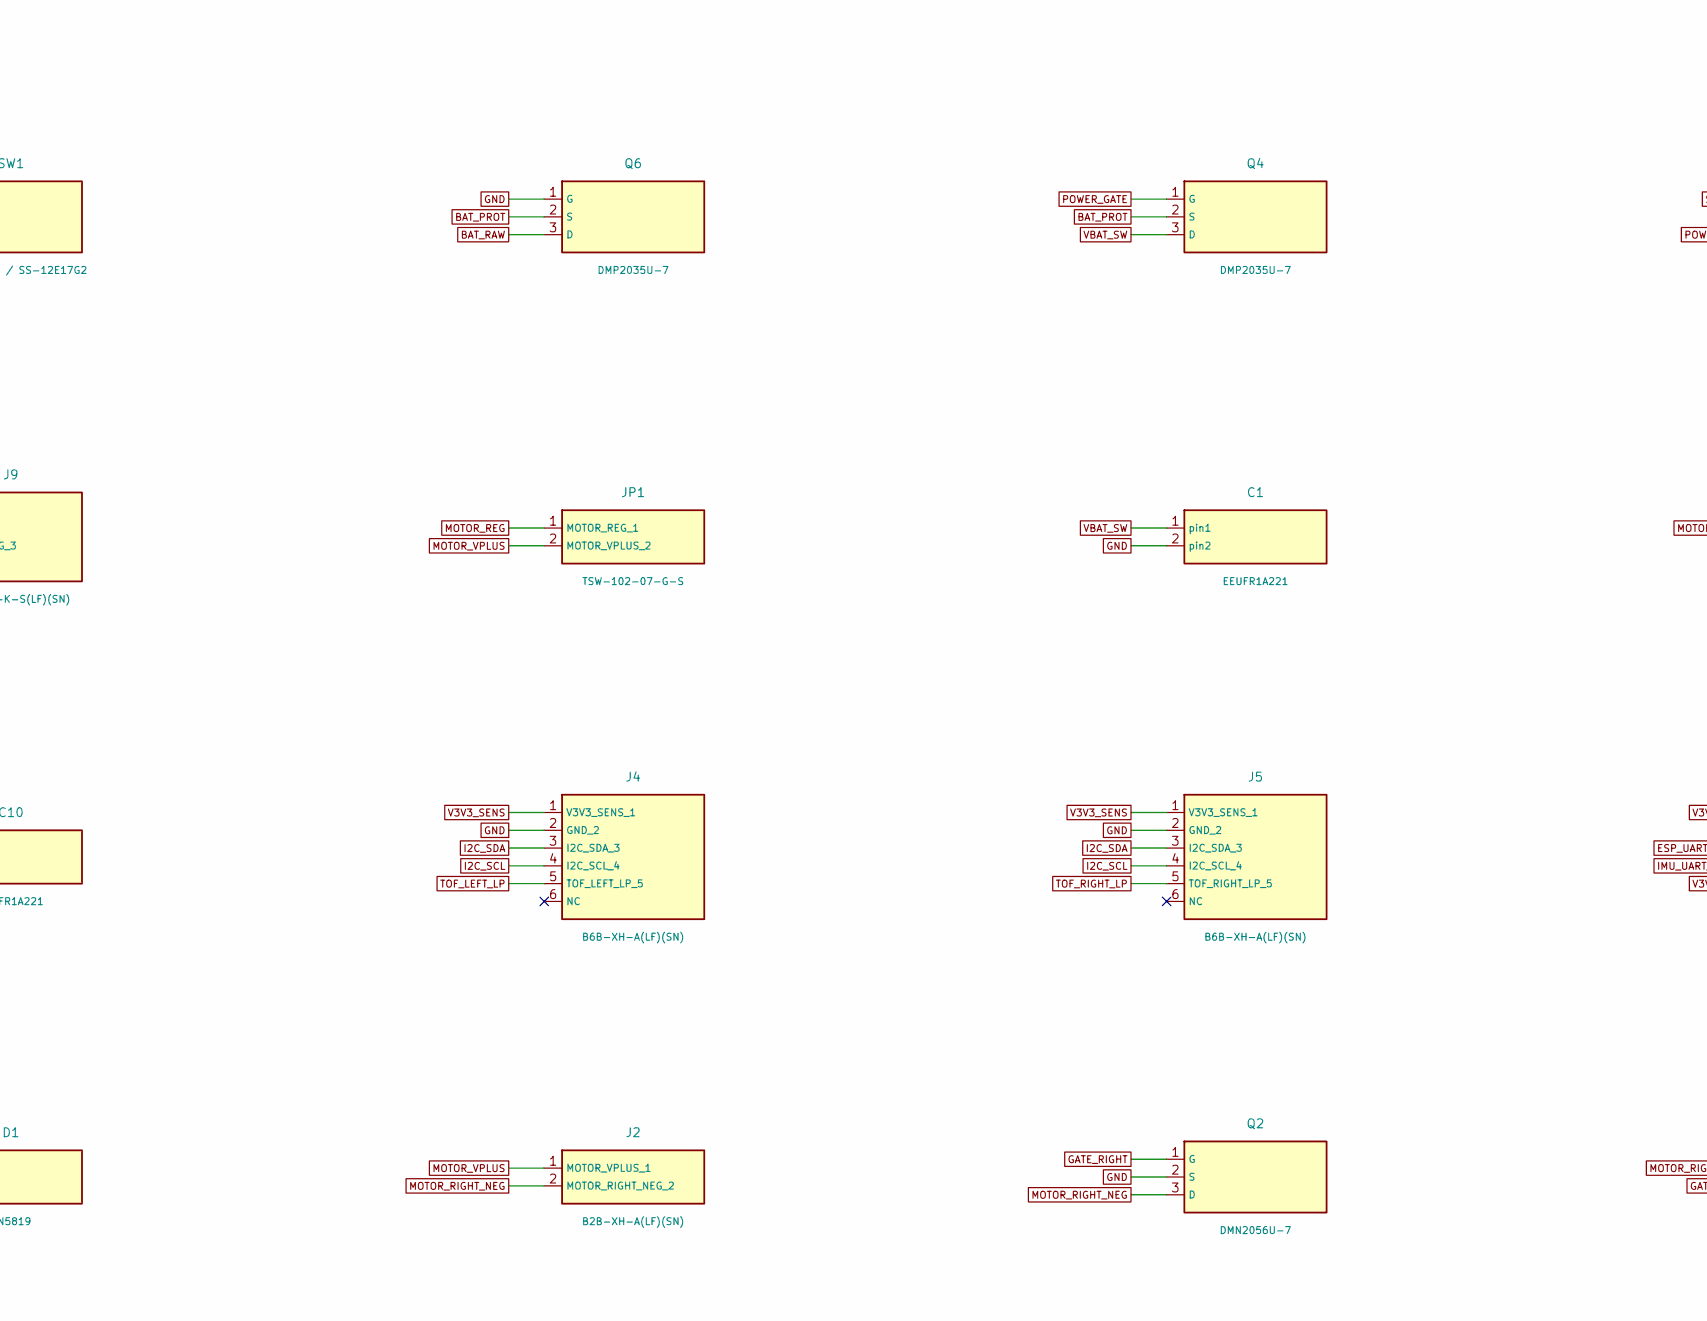
[picture p20: schematic headband-review.kicad_sch, Haptic navigation headband - carrier interface schematic, part in row 1, column 2]

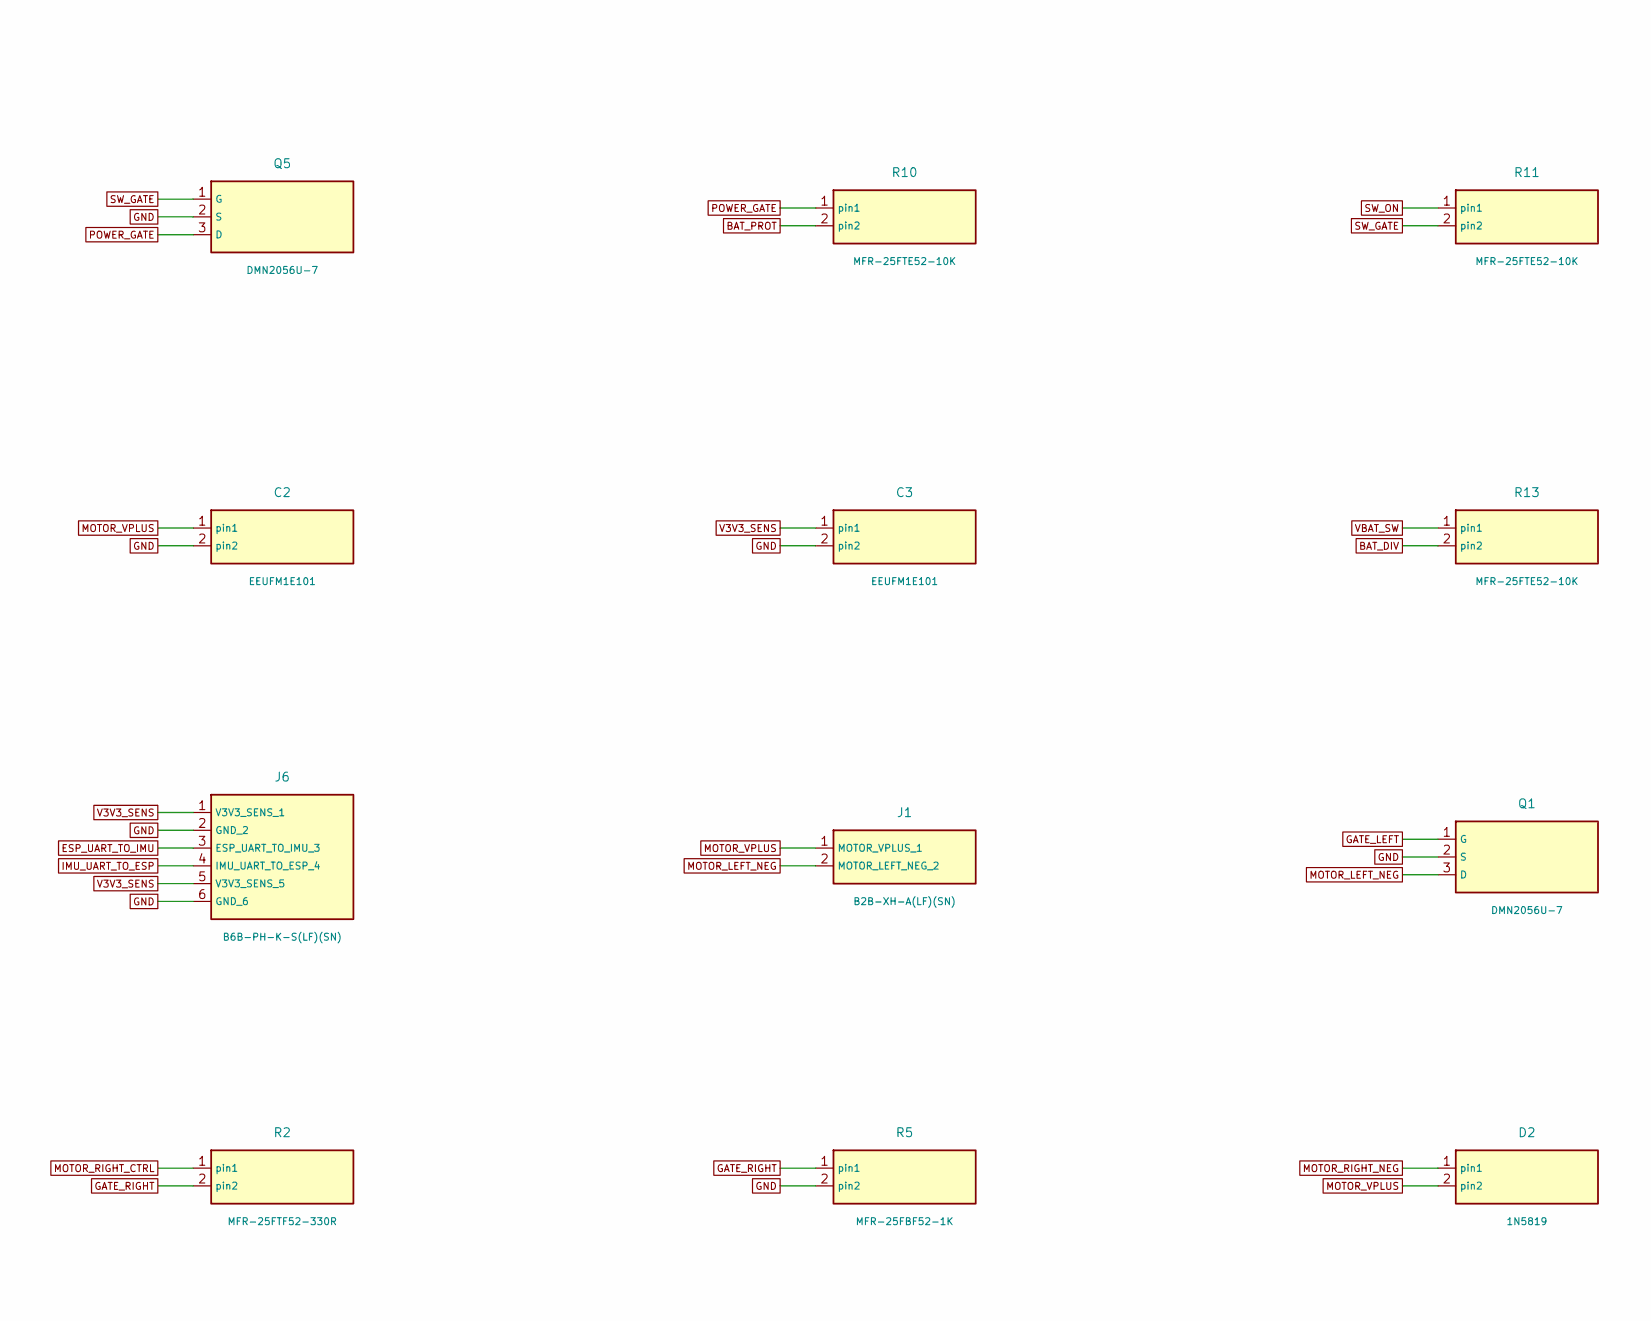
[picture p21: schematic headband-review.kicad_sch, Haptic navigation headband - carrier interface schematic, part in row 1, column 3]

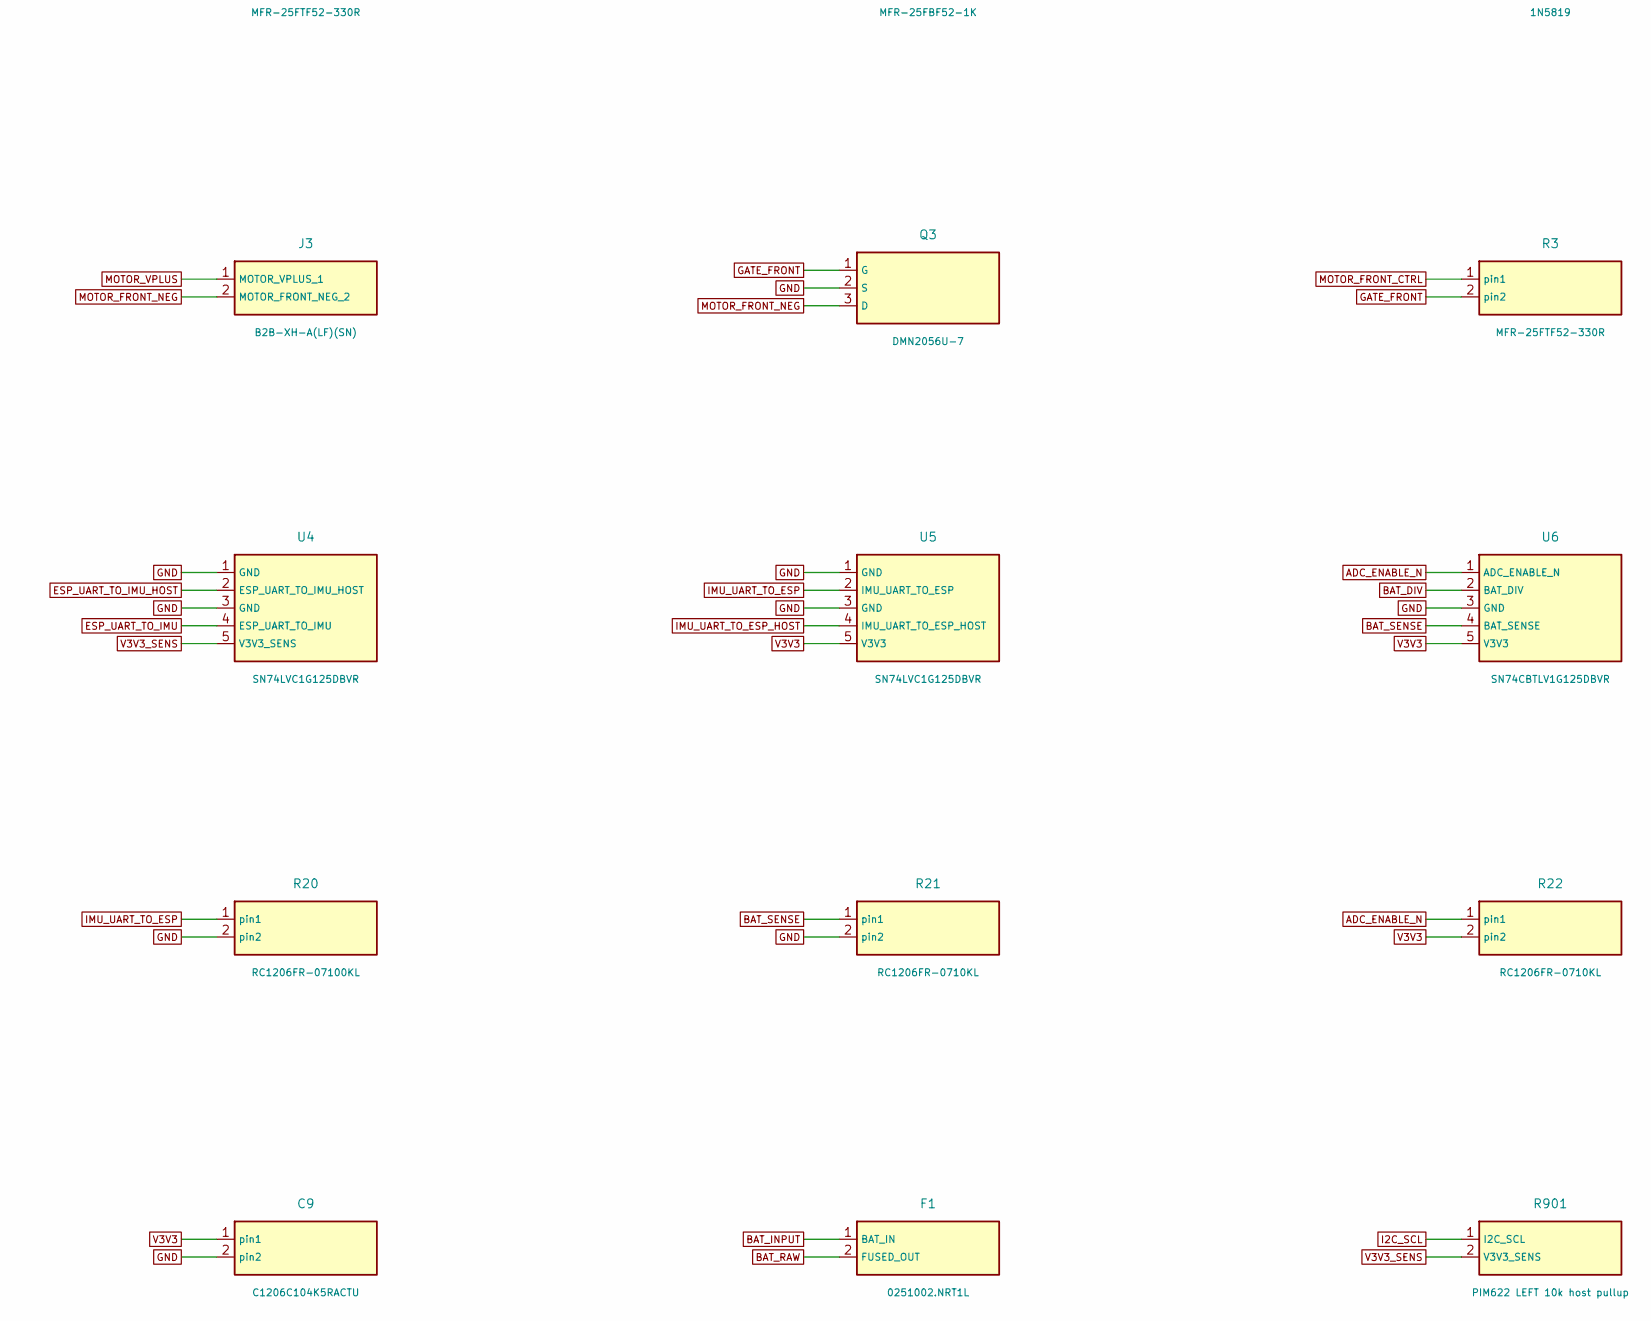
[picture p22: schematic headband-review.kicad_sch, Haptic navigation headband - carrier interface schematic, part in row 2, column 1]

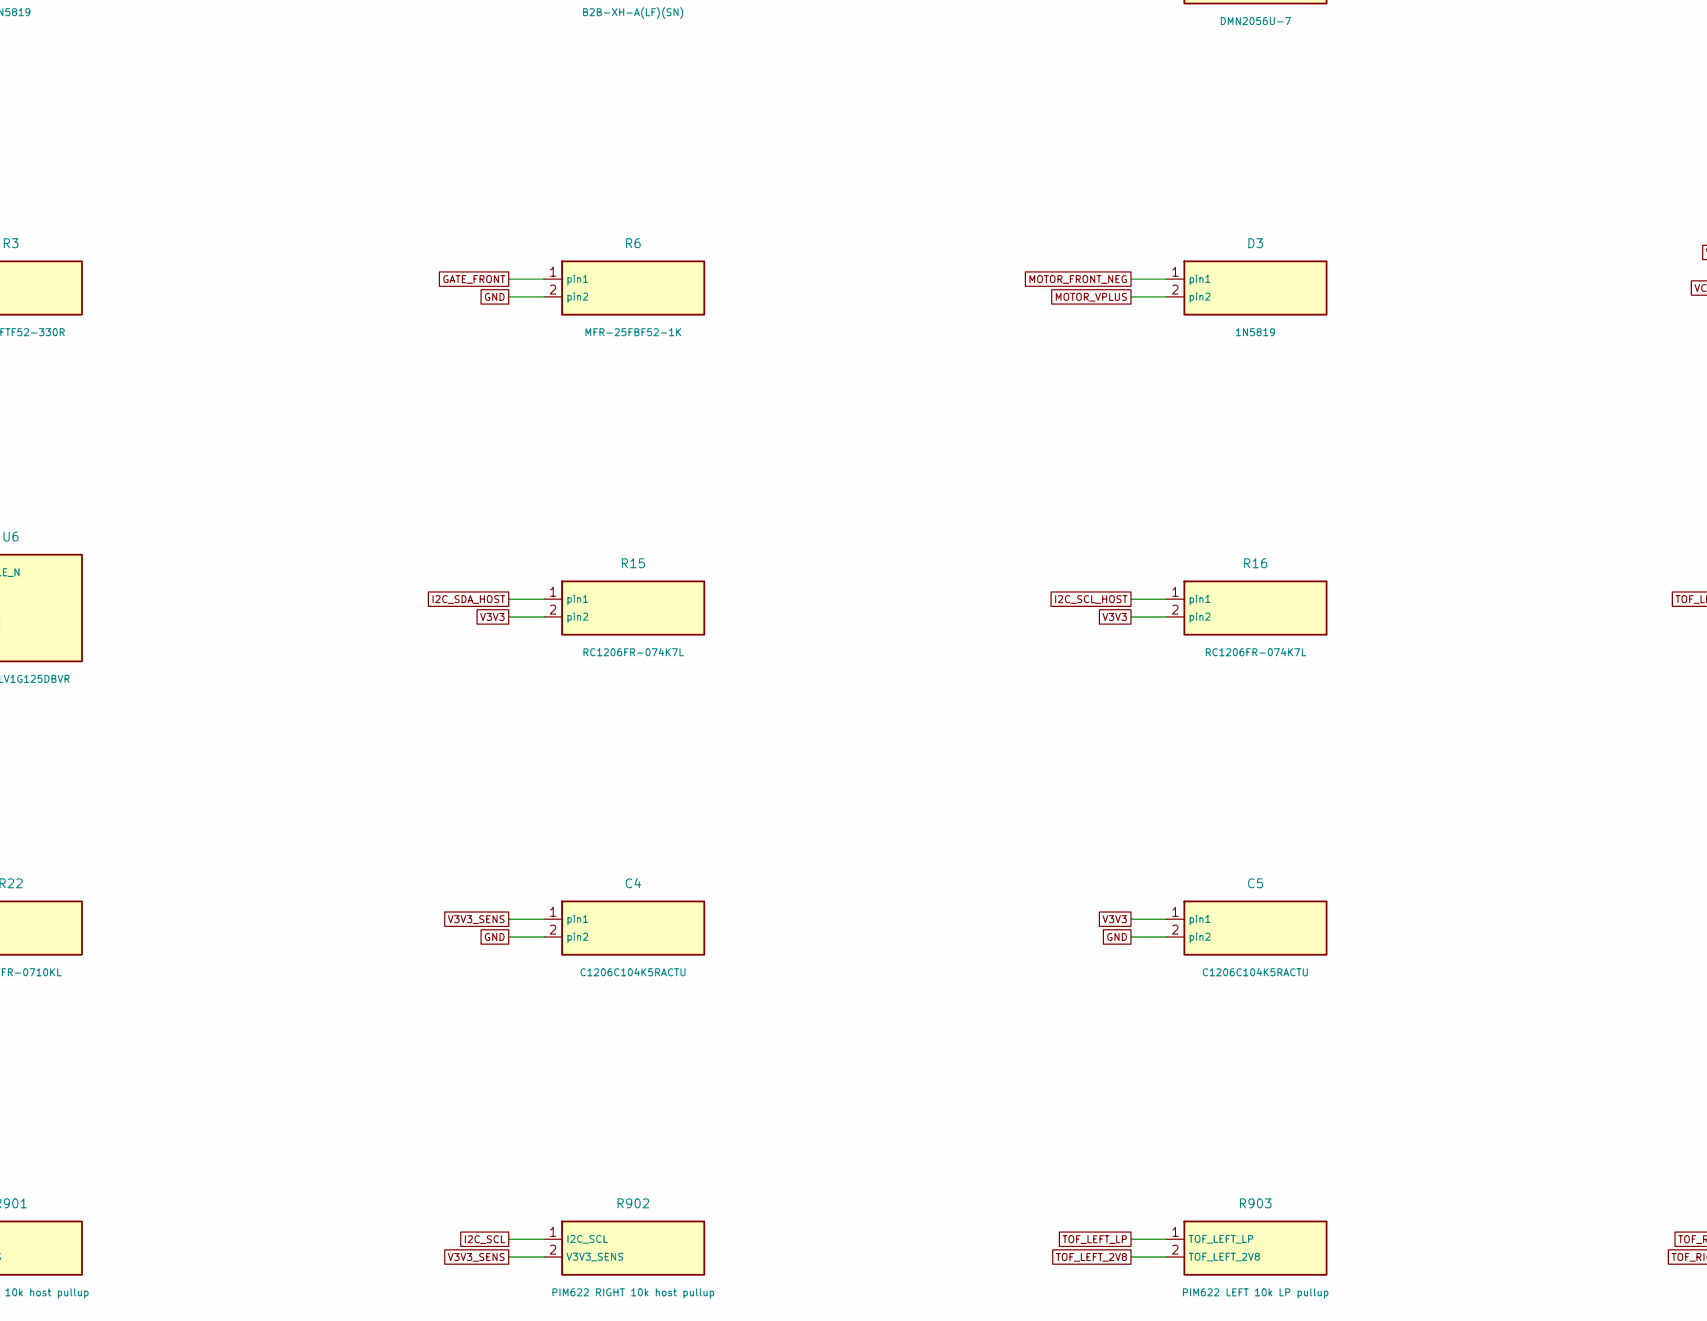
[picture p23: schematic headband-review.kicad_sch, Haptic navigation headband - carrier interface schematic, part in row 2, column 2]

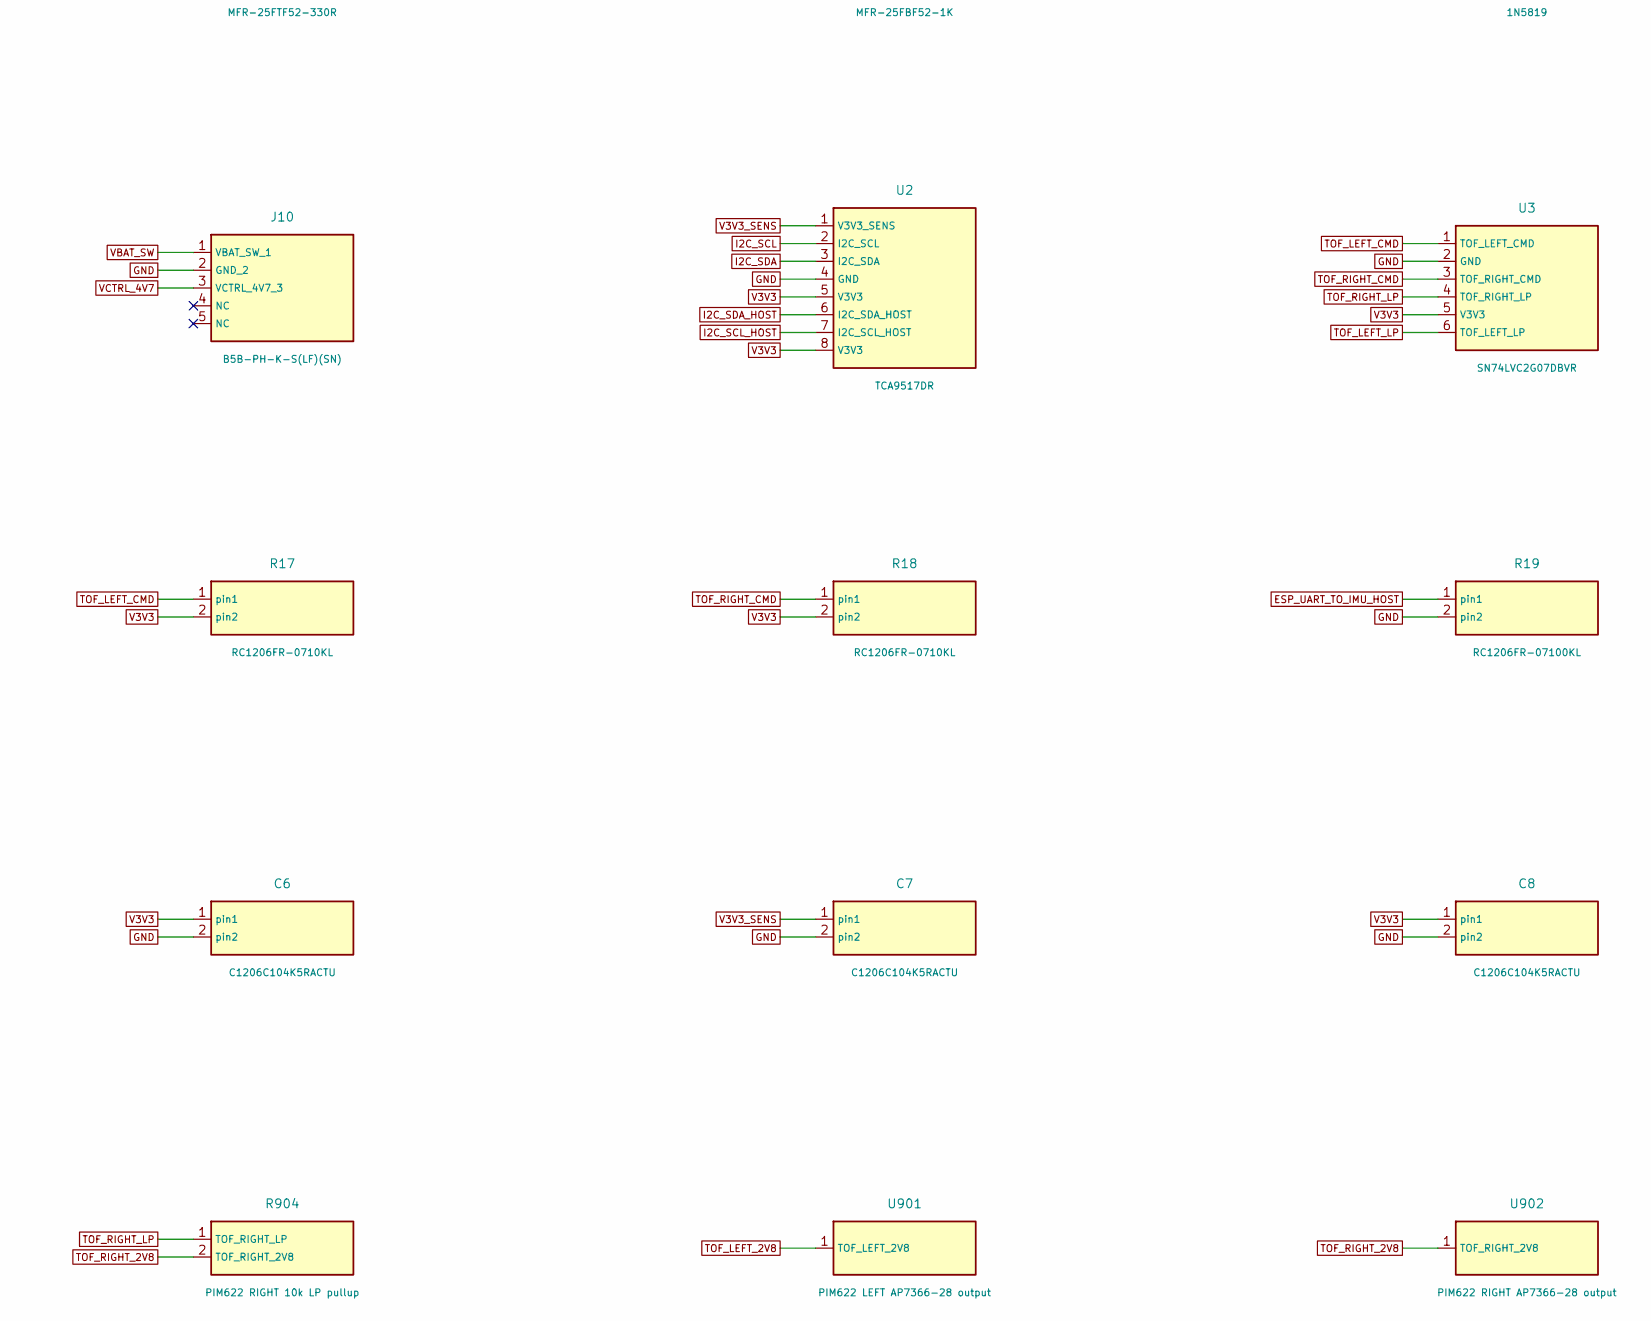
[picture p24: schematic headband-review.kicad_sch, Haptic navigation headband - carrier interface schematic, part in row 2, column 3]

Parts:
C1: EEUFR1A221; HB_C1
C2: EEUFM1E101; HB_C2
C3: EEUFM1E101; HB_C3
C4: C1206C104K5RACTU; HB_C4
C5: C1206C104K5RACTU; HB_C5
C6: C1206C104K5RACTU; HB_C6
C7: C1206C104K5RACTU; HB_C7
C8: C1206C104K5RACTU; HB_C8
C9: C1206C104K5RACTU; HB_C9
C10: EEUFR1A221; HB_C10
D1: 1N5819; HB_D1
D2: 1N5819; HB_D2
D3: 1N5819; HB_D3
F1: 0251002.NRT1L; HB_F1
J1: B2B-XH-A(LF)(SN); HB_J1
J2: B2B-XH-A(LF)(SN); HB_J2
J3: B2B-XH-A(LF)(SN); HB_J3
J4: B6B-XH-A(LF)(SN); HB_J4
J5: B6B-XH-A(LF)(SN); HB_J5
J6: B6B-PH-K-S(LF)(SN); HB_J6
J7: B2B-PH-K-S(LF)(SN); HB_J7
J8: B3B-PH-K-S(LF)(SN); HB_J8
J9: B4B-PH-K-S(LF)(SN); HB_J9
J10: B5B-PH-K-S(LF)(SN); HB_J10
JP1: TSW-102-07-G-S; HB_JP1
Q1: DMN2056U-7; HB_Q1
Q2: DMN2056U-7; HB_Q2
Q3: DMN2056U-7; HB_Q3
Q4: DMP2035U-7; HB_Q4
Q5: DMN2056U-7; HB_Q5
Q6: DMP2035U-7; HB_Q6
R1: MFR-25FTF52-330R; HB_R1
R2: MFR-25FTF52-330R; HB_R2
R3: MFR-25FTF52-330R; HB_R3
R4: MFR-25FBF52-1K; HB_R4
R5: MFR-25FBF52-1K; HB_R5
R6: MFR-25FBF52-1K; HB_R6
R10: MFR-25FTE52-10K; HB_R10
R11: MFR-25FTE52-10K; HB_R11
R12: MFR-25FTE52-100K; HB_R12
R13: MFR-25FTE52-10K; HB_R13
R14: MFR-25FTE52-10K; HB_R14
R15: RC1206FR-074K7L; HB_R15
R16: RC1206FR-074K7L; HB_R16
R17: RC1206FR-0710KL; HB_R17
R18: RC1206FR-0710KL; HB_R18
R19: RC1206FR-07100KL; HB_R19
R20: RC1206FR-07100KL; HB_R20
R21: RC1206FR-0710KL; HB_R21
R22: RC1206FR-0710KL; HB_R22
R901: PIM622 LEFT 10k host pullup
R902: PIM622 RIGHT 10k host pullup
R903: PIM622 LEFT 10k LP pullup
R904: PIM622 RIGHT 10k LP pullup
SW1: Adafruit 805 / SS-12E17G2; HB_SW1
TP1: TSW-106-07-G-S; HB_TP1
U1: Adafruit 4172; HB_U1
U2: TCA9517DR; HB_U2
U3: SN74LVC2G07DBVR; HB_U3
U4: SN74LVC1G125DBVR; HB_U4
U5: SN74LVC1G125DBVR; HB_U5
U6: SN74CBTLV1G125DBVR; HB_U6
U901: PIM622 LEFT AP7366-28 output
U902: PIM622 RIGHT AP7366-28 output

Connections:
ADC_ENABLE_N: R22.1, U1.7 (GPIO33), U6.1 (ADC_ENABLE_N)
BAT_DIV: R13.2, R14.1, U6.2 (BAT_DIV)
BAT_INPUT: F1.1 (BAT_IN), J7.1 (BAT_INPUT_1)
BAT_PROT: Q4.2 (S), Q6.2 (S), R10.2
BAT_RAW: F1.2 (FUSED_OUT), Q6.3 (D), SW1.2 (COMMON), TP1.1 (BAT_RAW_1)
BAT_SENSE: R21.1, U1.2 (GPIO36), U6.4 (BAT_SENSE)
ESP_UART_TO_IMU: J6.3 (ESP_UART_TO_IMU_3), U4.4 (ESP_UART_TO_IMU)
ESP_UART_TO_IMU_HOST: R19.1, U1.24 (GPIO17), U4.2 (ESP_UART_TO_IMU_HOST)
GATE_FRONT: Q3.1 (G), R3.2, R6.1
GATE_LEFT: Q1.1 (G), R1.2, R4.1
GATE_RIGHT: Q2.1 (G), R2.2, R5.1
GND: C1.2, C2.2, C3.2, C4.2, C5.2, C6.2, C7.2, C8.2, C9.2, C10.2, J4.2 (GND_2), J5.2 (GND_2), J6.2 (GND_2), J6.6 (GND_6), J7.2 (GND_2), J8.2 (GND_2), J9.2 (GND_2), J10.2 (GND_2), Q1.2 (S), Q2.2 (S), Q3.2 (S), Q5.2 (S), Q6.1 (G), R4.2, R5.2, R6.2, R12.2, R14.2, R19.2, R20.2, R21.2, TP1.2 (GND_2), U1.15 (GND), U1.36 (GND), U2.4 (GND), U3.2 (GND), U4.1 (GND), U4.3 (GND), U5.1 (GND), U5.3 (GND), U6.3 (GND)
I2C_SCL: J4.4 (I2C_SCL_4), J5.4 (I2C_SCL_4), R901.1 (I2C_SCL), R902.1 (I2C_SCL), U2.2 (I2C_SCL)
I2C_SCL_HOST: R16.1, U1.17 (GPIO22), U2.7 (I2C_SCL_HOST)
I2C_SDA: J4.3 (I2C_SDA_3), J5.3 (I2C_SDA_3), U2.3 (I2C_SDA)
I2C_SDA_HOST: R15.1, U1.16 (GPIO23), U2.6 (I2C_SDA_HOST)
IMU_UART_TO_ESP: J6.4 (IMU_UART_TO_ESP_4), R20.1, U5.2 (IMU_UART_TO_ESP)
IMU_UART_TO_ESP_HOST: U1.25 (GPIO16), U5.4 (IMU_UART_TO_ESP_HOST)
MOTOR_FRONT_CTRL: R3.1, U1.6 (GPIO32)
MOTOR_FRONT_NEG: D3.1, J3.2 (MOTOR_FRONT_NEG_2), Q3.3 (D)
MOTOR_LEFT_CTRL: R1.1, U1.11 (GPIO14)
MOTOR_LEFT_NEG: D1.1, J1.2 (MOTOR_LEFT_NEG_2), Q1.3 (D)
MOTOR_REG: J9.3 (MOTOR_REG_3), JP1.1 (MOTOR_REG_1)
MOTOR_RIGHT_CTRL: R2.1, U1.10 (GPIO27)
MOTOR_RIGHT_NEG: D2.1, J2.2 (MOTOR_RIGHT_NEG_2), Q2.3 (D)
MOTOR_VPLUS: C2.1, D1.2, D2.2, D3.2, J1.1 (MOTOR_VPLUS_1), J2.1 (MOTOR_VPLUS_1), J3.1 (MOTOR_VPLUS_1), JP1.2 (MOTOR_VPLUS_2), TP1.6 (MOTOR_VPLUS_6)
unnamed: R903.2 (TOF_LEFT_2V8), U901.1
unnamed: R904.2 (TOF_RIGHT_2V8), U902.1
POWER_GATE: Q4.1 (G), Q5.3 (D), R10.1
SW_GATE: Q5.1 (G), R11.2, R12.1
SW_ON: R11.1, SW1.3 (ON)
TOF_LEFT_CMD: R17.1, U1.8 (GPIO25), U3.1 (TOF_LEFT_CMD)
TOF_LEFT_LP: J4.5 (TOF_LEFT_LP_5), R903.1 (TOF_LEFT_LP), U3.6 (TOF_LEFT_LP)
TOF_RIGHT_CMD: R18.1, U1.9 (GPIO26), U3.3 (TOF_RIGHT_CMD)
TOF_RIGHT_LP: J5.5 (TOF_RIGHT_LP_5), R904.1 (TOF_RIGHT_LP), U3.4 (TOF_RIGHT_LP)
V3V3: C5.1, C6.1, C8.1, C9.1, R15.2, R16.2, R17.2, R18.2, R22.2, TP1.3 (V3V3_3), U1.14 (3_3V), U2.5 (V3V3), U2.8 (V3V3), U3.5 (V3V3), U5.5 (V3V3), U6.5 (V3V3)
V3V3_SENS: C3.1, C4.1, C7.1, J4.1 (V3V3_SENS_1), J5.1 (V3V3_SENS_1), J6.1 (V3V3_SENS_1), J6.5 (V3V3_SENS_5), J8.3 (V3V3_SENS_3), R901.2 (V3V3_SENS), R902.2 (V3V3_SENS), TP1.4 (V3V3_SENS_4), U2.1 (V3V3_SENS), U4.5 (V3V3_SENS)
VBAT_SW: C1.1, J8.1 (VBAT_SW_1), J9.1 (VBAT_SW_1), J10.1 (VBAT_SW_1), Q4.3 (D), R13.1, TP1.5 (VBAT_SW_5)
VCTRL_4V7: C10.1, J10.3 (VCTRL_4V7_3), U1.34 (VIN)

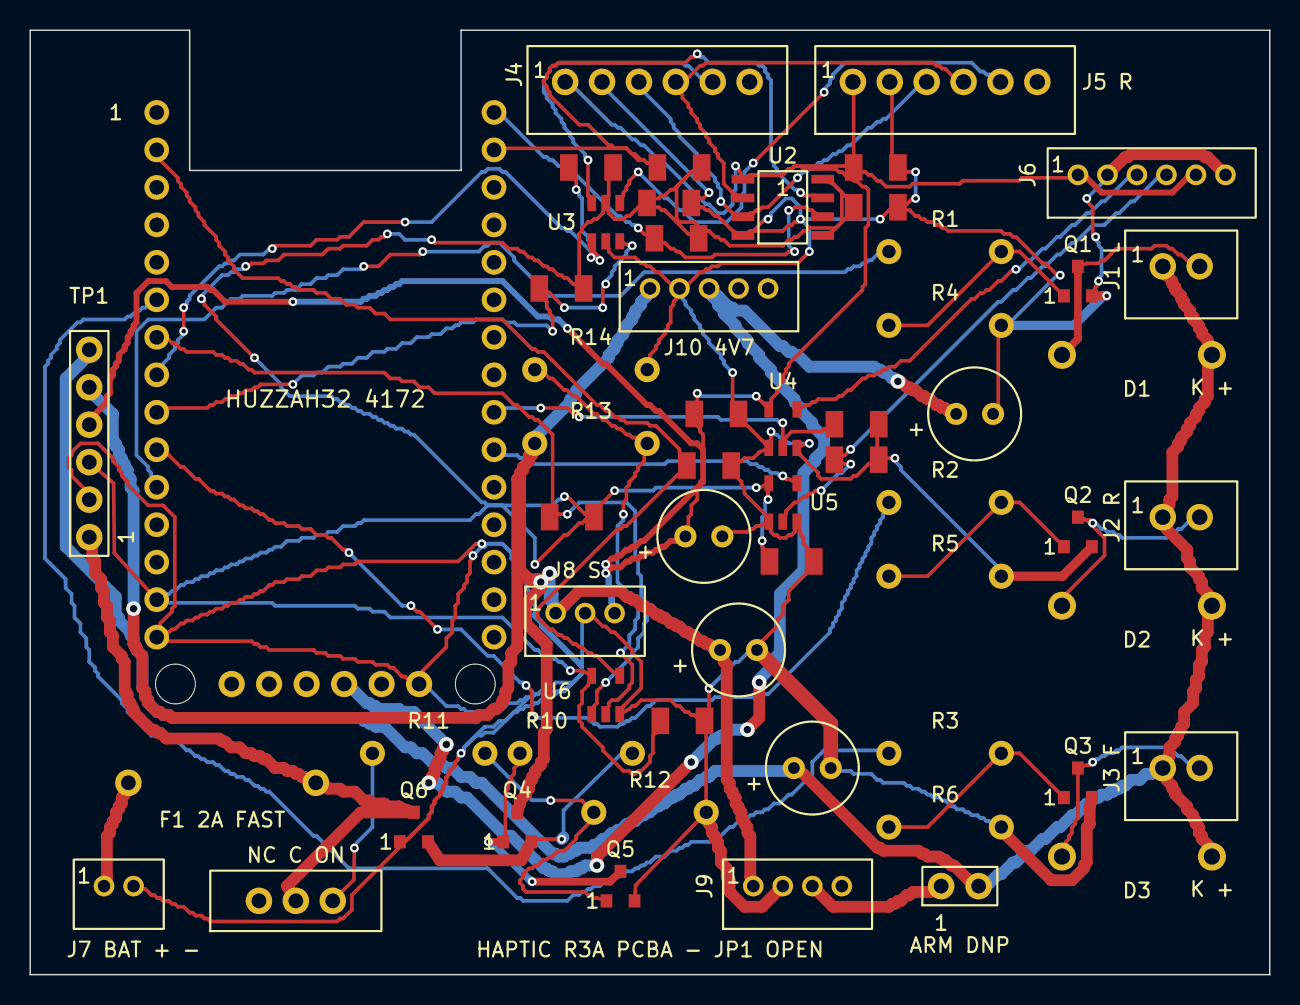
[picture p25: board headband-review.kicad_pcb from above]

Board: 2 copper layers, 84.0 x 64.0 mm, 58 parts (0 on the bottom side), 37 nets.
